AkariGroup/akari_hardware/AKARI/electronics/pcb/AKARI_M5_board_awA.png

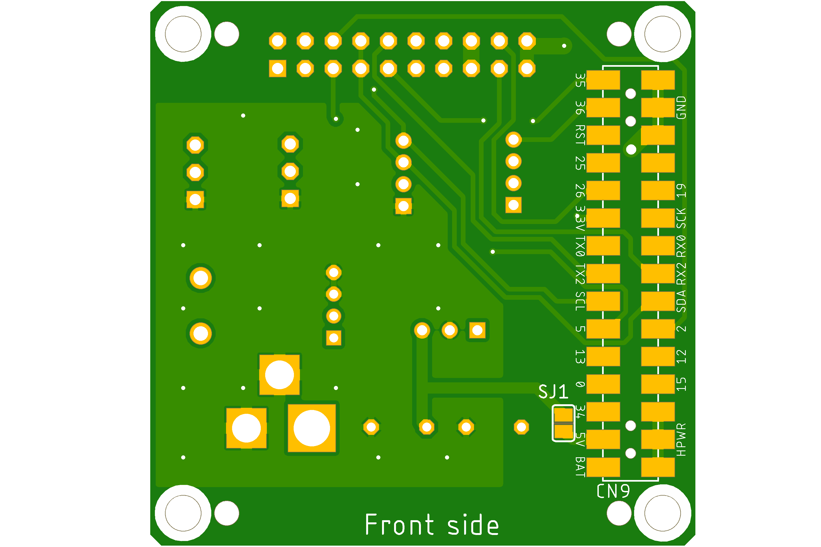
AKARI/electronics/pcb/AKARI_M5_board_awA.png
