AkariGroup/akari_hardware/AKARI_Light/electronics/pcb/AKARI_Light_board_awA.png

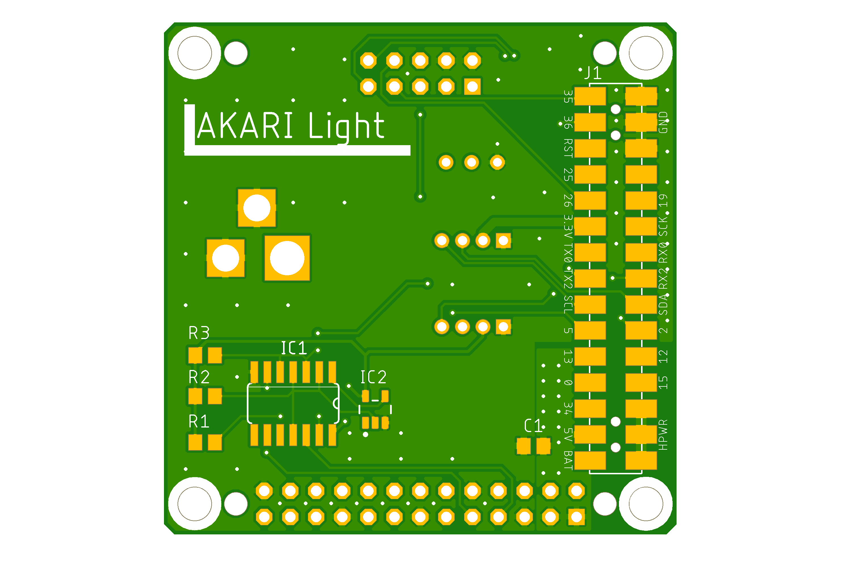
AKARI_Light/electronics/pcb/AKARI_Light_board_awA.png
