AkariGroup/akari_hardware/AKARI_Light/electronics/pcb/AKARI_Light_board_awB.png

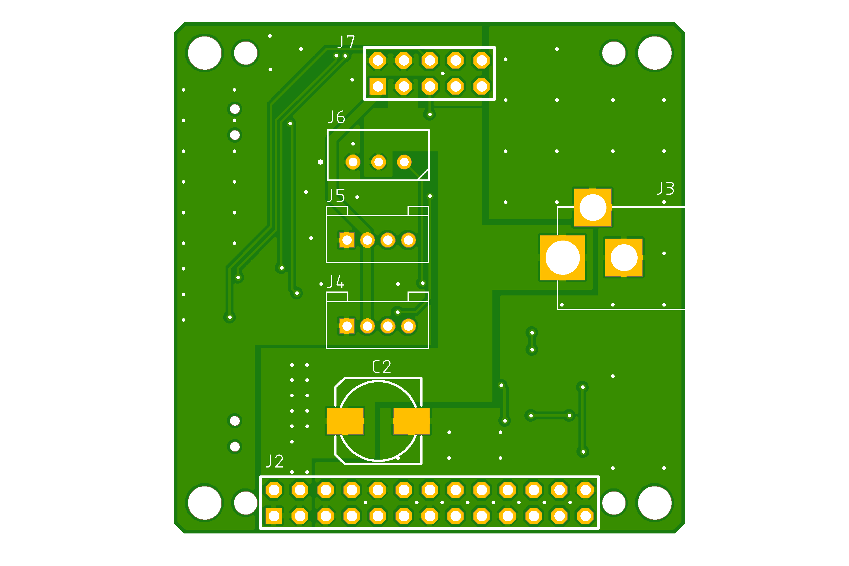
AKARI_Light/electronics/pcb/AKARI_Light_board_awB.png
