AkariGroup/akari_hardware/AKARI_Light/3d_models/AKARI_Light_bom.md

| #  | Parts | Item | Qty | Link |
| ---- | ---- | ---- | ---- | ---- |
| 13 | [AKARI_Light_Arm](AKARI_Light_Arm.stl) |3D print parts|1| |
| 14 | [AKARI_Light_Base](AKARI_Light_Base.stl) |3D print parts|1| |
| 15 | [AKARI_Light_Body](AKARI_Light_Body.stl) |3D print parts|1| |
| 16 | [AKARI_Light_Head](AKARI_Light_Head.stl) |3D print parts|1| |
| 17 | [AKARI_Light_Cover](AKARI_Light_Cover.stl) |3D print parts|1| |
| 18 | RaspberryPi 5 8GB | SBC |1| https://www.marutsu.co.jp/pc/i/46415211/ |
| 19 | M5Stack BASIC V2.7 | ESP32 develop kit|1| https://www.marutsu.co.jp/pc/i/2733151/ |
| 20 | STS3215 | Servo motor|2| https://www.marutsu.co.jp/pc/i/2349133/ |
| 21 | OAK-D-LITE |AI camera |1| https://www.marutsu.co.jp/pc/i/2235787/ |
| 22 | - | Active cooler (Raspberry pi)|1| https://www.marutsu.co.jp/pc/i/2782705/ |
| 23 | PRT-08535 | 2×5(10P) IDC cable|1| https://akizukidenshi.com/catalog/g/g103796/ |
| 24 | - | AC Adapter(5V/6.2A) |1| https://www.marutsu.co.jp/pc/i/2775202/ |
| 25 | - | screw M4-5|6| https://www.amazon.co.jp/dp/B07MZQTTTV |
| 26 | - | USB Type-C L 0.5m|1| https://www.amazon.co.jp/dp/B08RMFTGHZ |
| 27 | - | microSD(128GB) |1|  | https://www.amazon.co.jp/dp/B0CH2X5LBX |
| 28 | - | microSD(8GB) |1| https://www.amazon.co.jp/dp/B00VQOEWYO |
| 29 | M5STACK-U001-C | M5 ENV IV Sensor|1| https://www.marutsu.co.jp/pc/i/2764443/ |
| 30 | M5STACK-LIGHT-UNIT | M5 Light Sensor|1| https://www.marutsu.co.jp/pc/i/1526328/ |
