AkariGroup/akari_hardware/AKARI_Light/electronics/pcb/AKARI_Light_board_bom_JLCSMT.xlsx

Comment | Designator | Footprint | JLCPCB Part #（optional）
R0805 10k | R1 | 0805W8F1002T5E | C17414 | https://jlcpcb.com/partdetail/18102-0805W8F1002T5E/C17414
R0805 1k | R2,R3 | 0805W8F1001T5E | C17513 | https://jlcpcb.com/partdetail/18201-0805W8F1001T5E/C17513
C0805 100nF | C1 | CC0805KRX7R9BB104 | C49678 | https://jlcpcb.com/partdetail/Yageo-CC0805KRX7R9BB104/C49678
74HC126D | IC1 | SN74HC126DR | C7644 | https://jlcpcb.com/partdetail/TexasInstruments-SN74HC126DR/C7644
SN74AHC1 | IC2 | SN74AHC1G04DBVR | C7465 | https://jlcpcb.com/partdetail/TexasInstruments-SN74AHC1G04DBVR/C7465
