AkariGroup/akari_hardware/AKARI/3d_models/forROS/AKARI-SERVO.stl

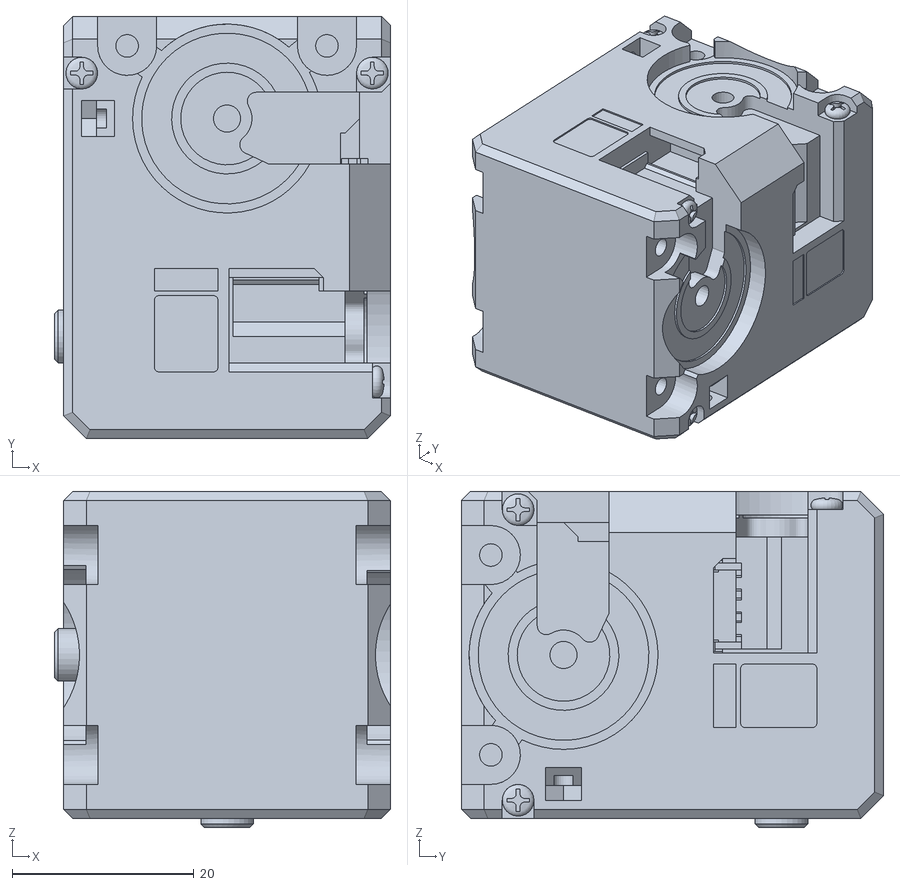
[picture p5: CAD file, 2024-04-01]
AKARI/3d_models/forROS/AKARI-SERVO.stl
37.0 x 46.5 x 37.0
