AkariGroup/akari_hardware/AKARI/3d_models/forROS/AKARI-HEAD.stl

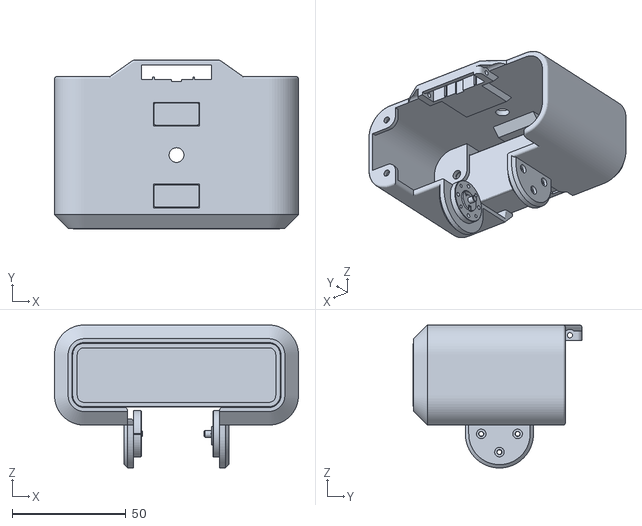
[picture p6: CAD file, 2024-04-01]
AKARI/3d_models/forROS/AKARI-HEAD.stl
107.3 x 74.3 x 62.9
