AkariGroup/akari_hardware/(list of files, cad)

Other CAD files:
AKARI/3d_models/AKARI_Body.step
AKARI_Light/3d_models/AKARI_Light_Arm.step
AKARI/3d_models/AKARI_Base.step
AKARI_Light/3d_models/AKARI_Light_Body.step
AKARI/3d_models/AKARI.step
AKARI_Light/3d_models/AKARI_Light.step
AKARI/3d_models/AKARI_Plate.step
AKARI_Light/3d_models/AKARI_Light_Cover.step
AKARI/3d_models/AKARI_Head.step
AKARI_Light/3d_models/AKARI_Light_Base.step
AKARI/3d_models/AKARI_Cover.step
AKARI_Light/3d_models/AKARI_Light_Head.step
AKARI/3d_models/AKARI_Base.stl
AKARI/3d_models/AKARI_Body.stl
AKARI/3d_models/AKARI_Cover.stl
AKARI/3d_models/AKARI_Head.stl
AKARI/3d_models/AKARI_Plate.stl
AKARI_Light/3d_models/AKARI_Light_Arm.stl
AKARI_Light/3d_models/AKARI_Light_Base.stl
AKARI_Light/3d_models/AKARI_Light_Body.stl
AKARI_Light/3d_models/AKARI_Light_Cover.stl
AKARI_Light/3d_models/AKARI_Light_Head.stl
