AkariGroup/akari_hardware/AKARI_Light/electronics/pcb/AKARI_Light_board_sch.pdf

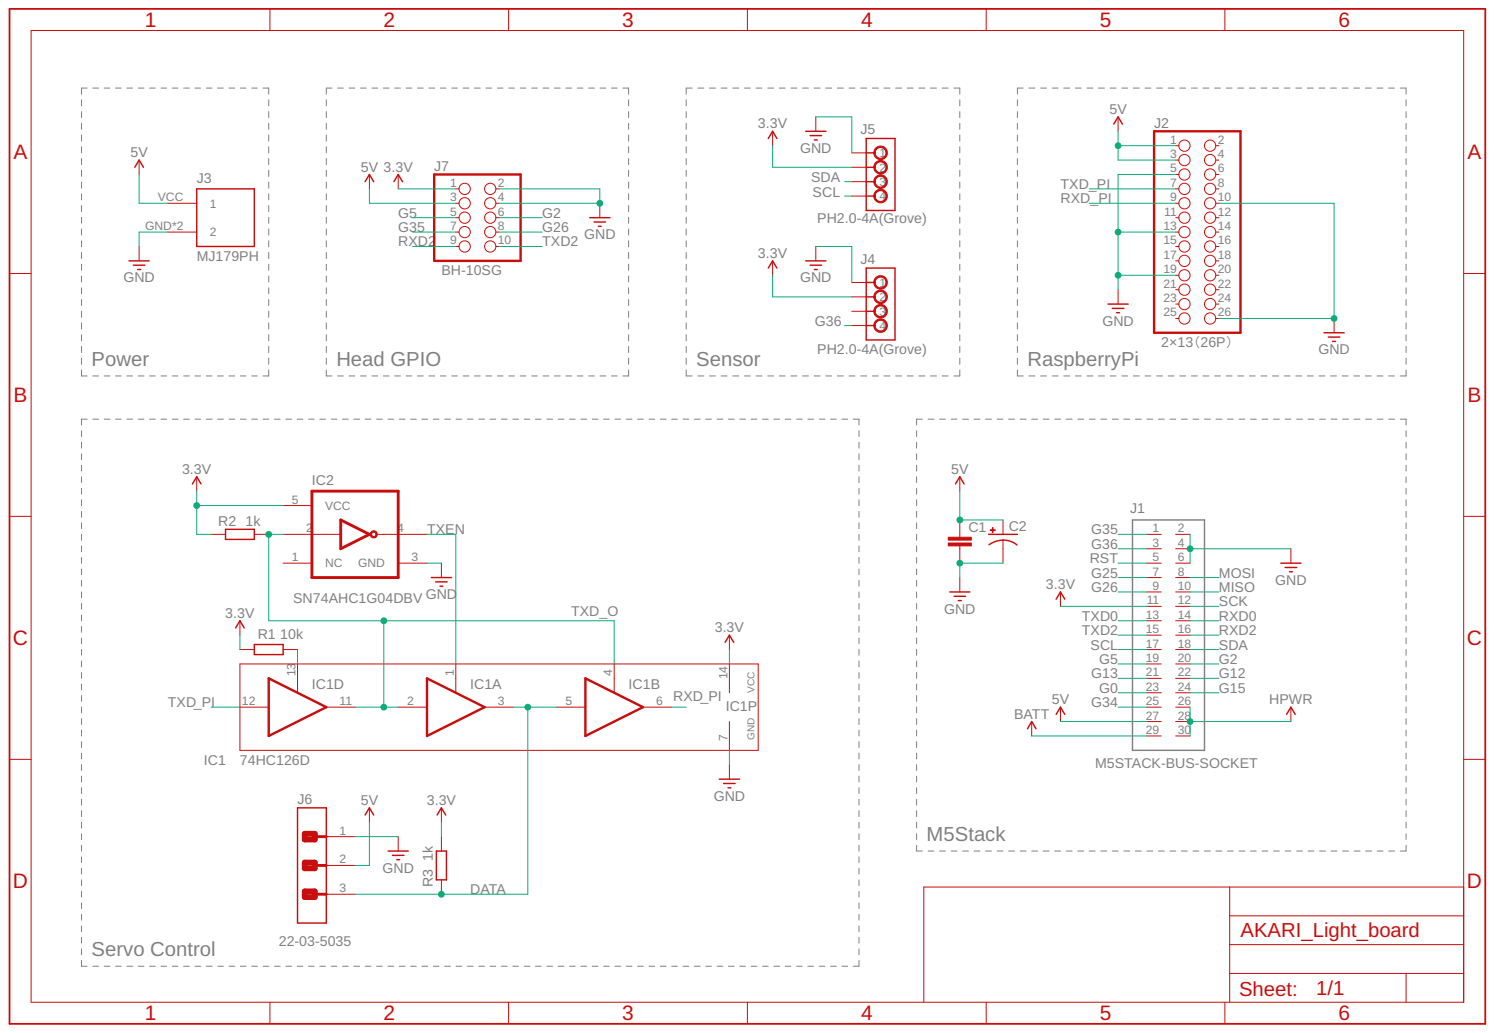
[picture p7: page 1]
