AkariGroup/akari_hardware/AKARI/electronics/pcb/AKARI_M5_board_sch.pdf

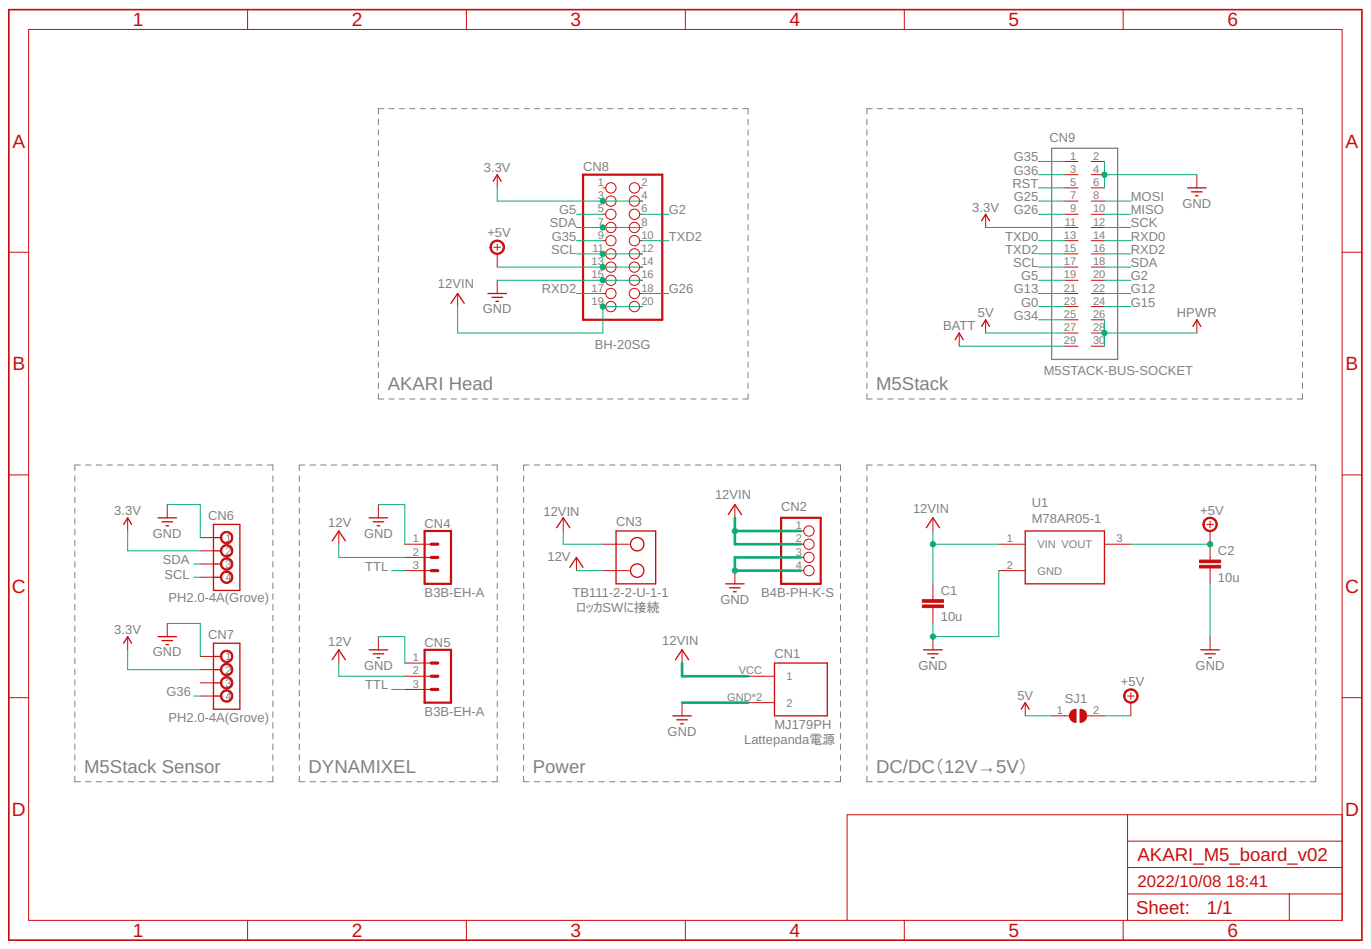
[picture p8: page 1]
