AkariGroup/akari_hardware/AKARI_Light/head_units/test_unit/pcb/AKARI_Light_Test_Head_Unit.pdf

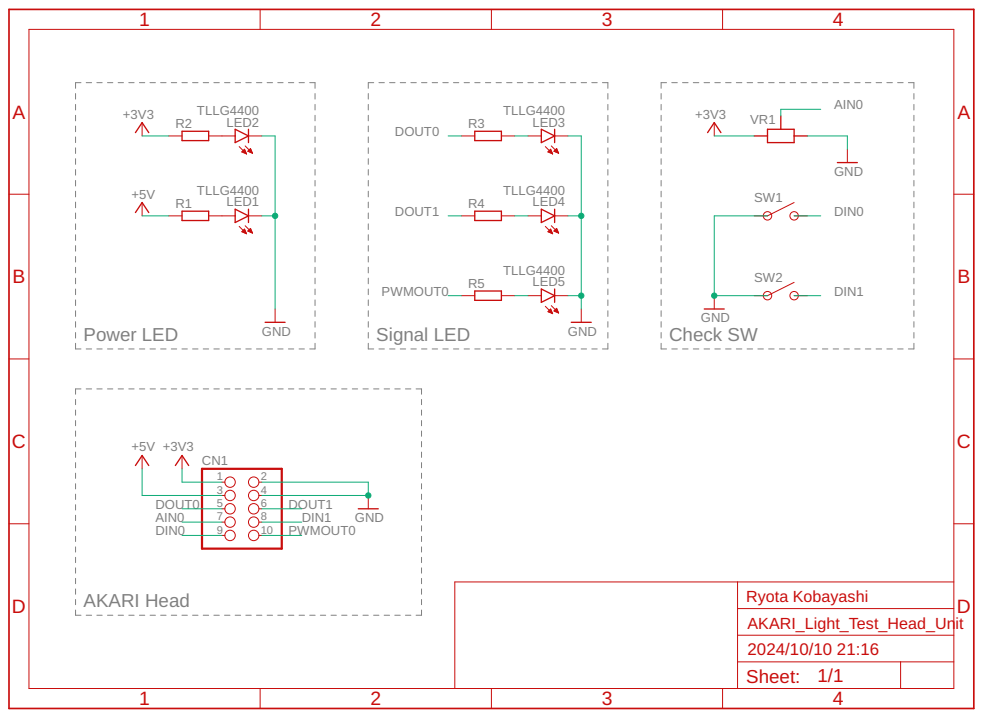
[picture p9: page 1]
