AkariGroup/akari_hardware/AKARI/head_units/test_unit/pcb/AKARI_Test_Head_Unit_sch.pdf

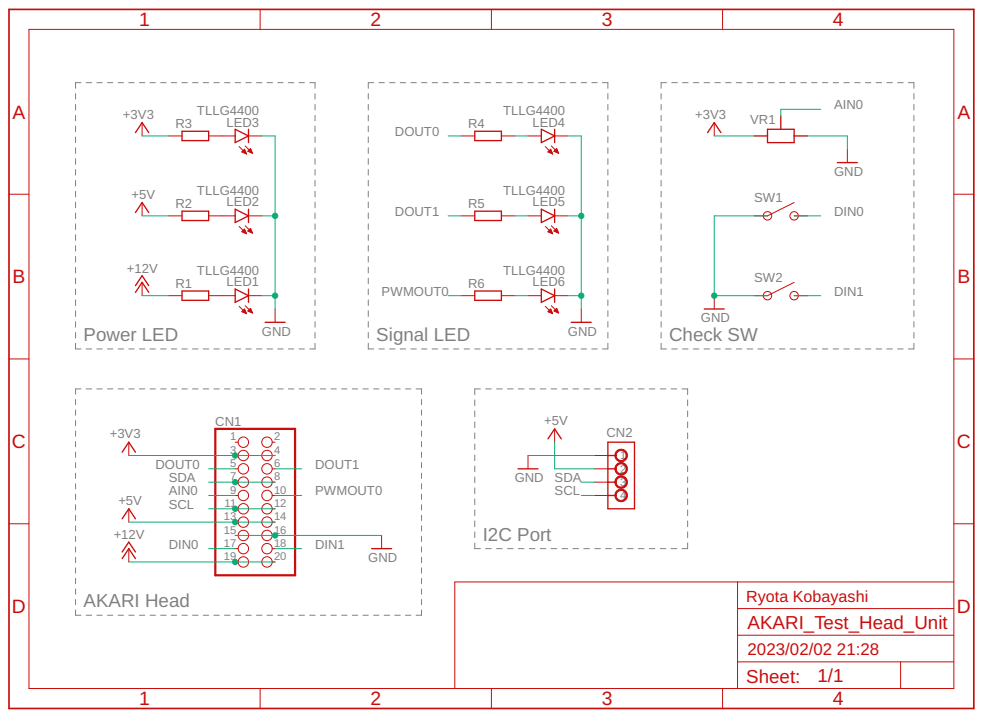
[picture p10: page 1]
