AkariGroup/akari_hardware/AKARI/head_units/test_unit/pcb/AKARI_Test_Head_Unit_awA.png

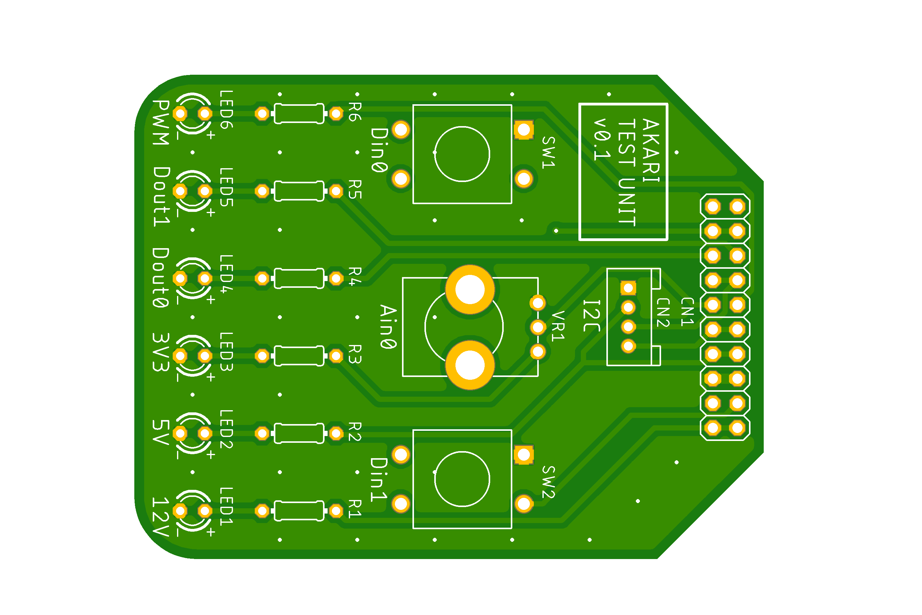
AKARI/head_units/test_unit/pcb/AKARI_Test_Head_Unit_awA.png
