AkariGroup/akari_hardware/AKARI/head_units/test_unit/pcb/AKARI_Test_Head_Unit_awB.png

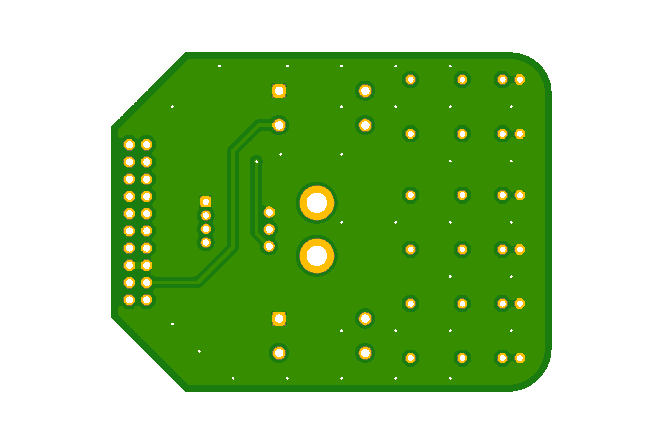
AKARI/head_units/test_unit/pcb/AKARI_Test_Head_Unit_awB.png
