AkariGroup/akari_hardware/AKARI_Light/head_units/test_unit/pcb/AKARI_Test_Head_Unit_awA.png

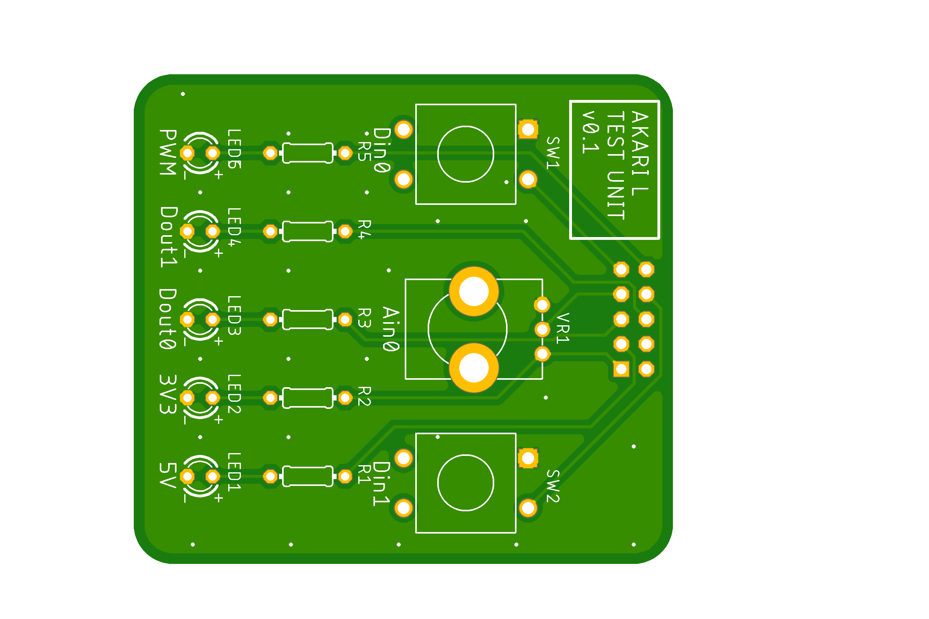
AKARI_Light/head_units/test_unit/pcb/AKARI_Test_Head_Unit_awA.png
