AkariGroup/akari_hardware/(threads)

Thread 3 (2023-09-08):

M5Stack用2x15ピンヘッダが傾いてついてしまう

Wisteria720, 2023-09-08:
M5Stack用2x15ピンヘッダの実装において、「ピンヘッダの位置決めの突起に対して基板側の穴が小さいので傾いてはんだ付けしてしまう」という意見あり->[該当工程マニュアル](https://akarigroup.github.io/docs/source/assembly/assembly_hard/assembly_pcb.html#id4)
一応押し込めば突起が削れて傾かなくはなりますが、基板側の穴を大きくすることはできませんか？
参考：穴1.0㎜、ピンヘッダ突起1.2㎜
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
