AkariGroup/akari_hardware/(commit log)

2023-03-05 copy from developer
    [AKARI.step, AKARI_Base.step, AKARI_Base.stl, AKARI_Body.step, AKARI_Body.stl, AKARI_Cover.stl, AKARI_Head.step, AKARI_Head.stl]
2023-03-06 add cover model
    [AKARI_Cover.step]
2023-04-07 modify dc jack
    [AKARI.step, AKARI_Base.step, AKARI_Base.stl, AKARI_Body.step, AKARI_Body.stl]
2024-03-30 add ros stl file
    [AKARI-HEAD.stl, AKARI-SERVO.stl]
2024-12-19 Develop AKARI Light (#4)
    * add new M5board
    * add akari mini aw
    * Add jlcpcb bom
    * Update part list
    * add bom
    * add stl file
    * modify location
    * add 3dmodel
    * add BOM
    * Fix bom and add parts link
    * Fix link
    * Add part link
    * Fix part link
    * Update AC adapter
    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
    [AKARI-HEAD.stl, AKARI-SERVO.stl, AKARI.step, AKARI_Base.step, AKARI_Base.stl, AKARI_Body.step, AKARI_Body.stl, AKARI_Cover.step]
